old-bridge/2026_higaeri/codes/TFT画面イメージ/image1.jpg

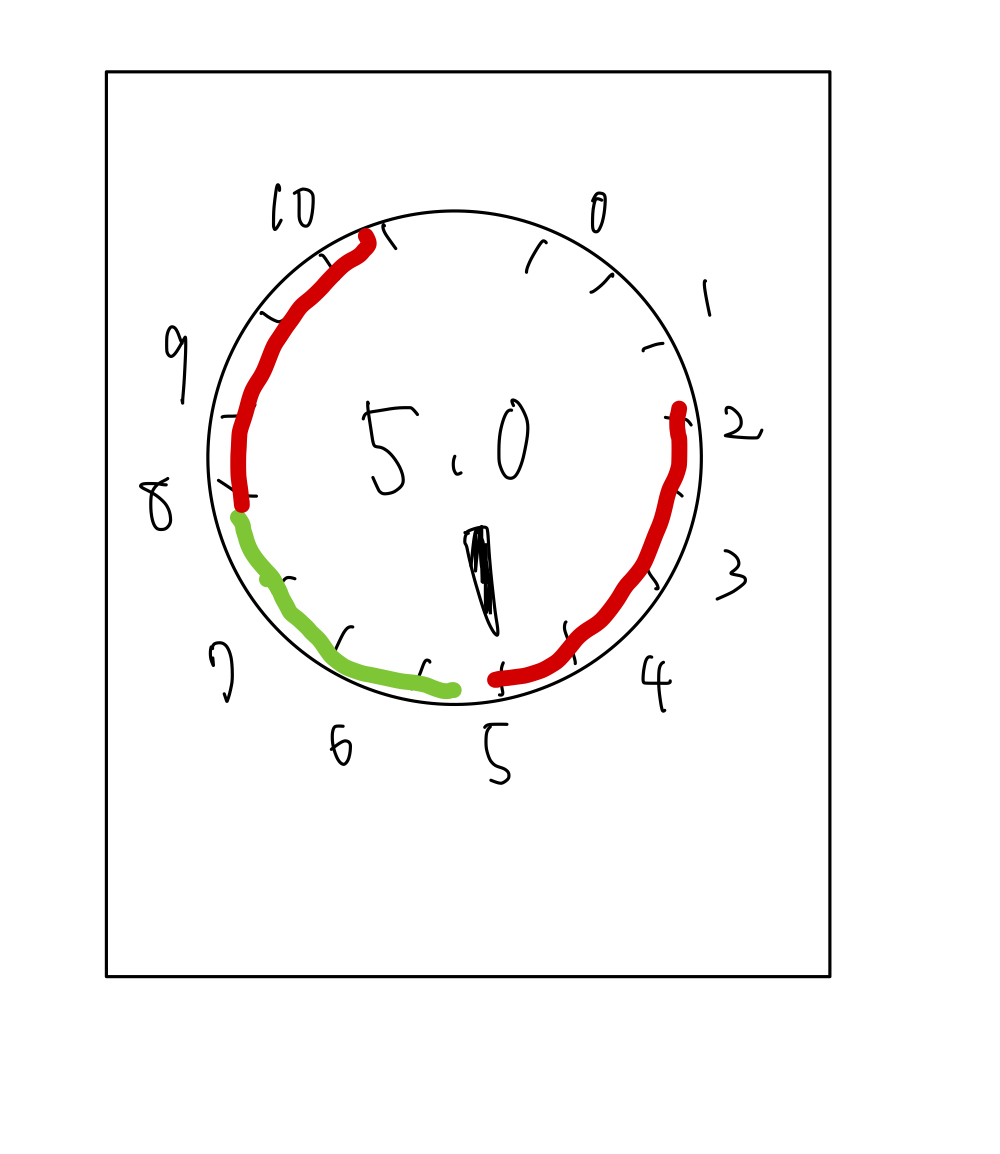
codes/TFT画面イメージ/image1.jpg
