old-bridge/2026_higaeri/codes/COMPILATION_FIXES.md

# Compilation Errors - Fix Summary

## issues Fixed

### 1. **#error "DE_PIN must be defined"**
**Problem**: DE_PIN was defined in the .ino files, but wasn't accessible to the .cpp files when compiled as separate units.

**Solution**: Created `pins.h` files in each subfolder that:
- Define DE_PIN with appropriate values for each board
- Use `#if !defined(DE_PIN)` to allow .ino files to override
- Are included before ModbusConfig.h in all files

**Files created**:
- `air_data/pins.h` (DE_PIN: D10)
- `display/pins.h` (DE_PIN: D3)
- `logger/pins.h` (DE_PIN: D2)
- `master/pins.h` (DE_PIN: D5)
- `slave/pins.h` (DE_PIN: D5)

### 2. **Redefinition Errors in ModbusRTU.h**
**Problem**: ModbusRTU.h was included multiple times without include guards, causing:
- `error: redefinition of 'const uint16_t crc_table [256]'`
- `error: redefinition of 'class ModbusRTU'`
- etc.

**Solution**: 
- Added `#ifndef MODBUS_RTU_H` / `#define MODBUS_RTU_H` guards at the top of `libraries/ModbusRTU/src/ModbusRTU.h`
- Added closing `#endif` at the end
- Direct include of `ModbusRTU.h` is now used because the current library header already has `#pragma once`

**Files modified**:
- `libraries/ModbusRTU/src/ModbusRTU.h` - Added header guards
- Removed local `ModbusRTU_wrapper.h`; local modules include `ModbusRTU.h` directly

### 3. **Include Structure Issues**
**Problem**: 
- .ino files were directly `#include`ing .cpp files, causing duplicate includes
- This resulted in ModbusRTU.h being included multiple times
- Multiple definitions of static variables

**Solution**:
- Removed `#include "ModbusSlave.cpp"` and `#include "ModbusMaster.cpp"` from .ino files
- Let Arduino IDE compile .cpp files as separate compilation units
- Updated .ino files to only include .h files

**Files modified**:
- `air_data/air_data.ino`
- `display/display_d1.ino`

### 4. **Updated ModbusConfig.h**
**Changes**:
- Added `#include "pins.h"` at the top
- Removed the `#error` directive that required manual DE_PIN definition
- Files updated in: air_data/, display/

### 5. **Updated Header Files**
**Changes**:
- ModbusSlave.h and ModbusMaster.h now include `<ModbusRTU.h>` directly
- Files updated in: air_data/, display/

## Remaining Issues

The following API mismatch errors still need investigation:
- `'class ModbusRTU' has no member named 'begin'`
- `'class ModbusRTU' has no member named 'slave'`
- `'class ModbusRTU' has no member named 'task'`
- `'class ModbusRTU' has no member named 'Hreg'`
- `'class ModbusRTU' has no member named 'readHreg'`
- `'class ModbusRTU' has no member named 'writeHreg'`
- `'class ModbusRTU' has no member named 'addHreg'`
- `'class ModbusRTU' has no member named 'onGetHreg'`
- `'class ModbusRTU' has no member named 'onSetHreg'`

These suggest that the ModbusSlave.cpp and ModbusMaster.cpp implementations were written for a different API than what's currently in the ModbusRTU library. The library might have methods like `startModbusServer()` and `startModbusClient()` instead, or the API signatures are different.

## Next Steps

1. Review the ModbusRTU library documentation to understand the correct API
2. Update ModbusSlave.cpp and ModbusMaster.cpp to use the actual available methods
3. Or, if the library version is different from expected, consider updating the library or the implementation files
