old-bridge/2026_higaeri/(commit log)

2026-02-24 Add D-1/D-2 display, ModbusMaster and docs
    Introduce split display firmware and master implementation: add display_d1 (Modbus slave + I2C master to D-2) and display_d2 (I2C slave sensor provider), remove legacy display.ino, and implement ModbusMaster.cpp with synchronous read/write and baud-switch logic. Update ModbusConfig.h to rename/display D-1/D-2 register and slave ID constants, and adjust logger.ino to read from Display D-1 and use the new baud-change flow. Also add .github/copilot-instructions.md documenting system architecture, Modbus register model, and development notes.
2026-03-18 added boards
    [TFTboard.kicad_sch, higaeri.kicad_pcb, higaeri.kicad_sch, loggerboard.kicad_sch, untitled.kicad_sch]
2026-03-20 modbus動作確認できた
2026-03-21 ロガー-ディスプレイ間通信確認
2026-03-23 増幅回路追加
    [RE12A_amplifier.kicad_sch, higaeri.kicad_pcb, higaeri.kicad_sch, loggerboard.kicad_sch, untitled.kicad_sch]
2026-03-23 DRCエラー解消
    [RE12A_amplifier.kicad_sch, TFTboard.kicad_sch, higaeri.kicad_pcb, untitled.kicad_sch]
2026-03-24 シルクスクリーン修正
    [higaeri.kicad_pcb]
2026-03-25 ファイル名変更
    [bom.csv, designators.csv, higaeri.kicad_pcb, positions.csv]
2026-03-25 ライブラリ追加
2026-03-28 動作確認をもとに統合版コード修正
    [RE12A_amplifier.kicad_sch, bom.csv, designators.csv, higaeri.kicad_pcb, positions.csv, untitled.kicad_sch]
2026-03-29 統合版最小構成で動作確認
2026-03-29 air_data: 風速サンプリングをmicros()と実経過時間ベースに変更
    millis()による固定500msウィンドウをmicros()に切り替え、実際の経過時間を計測して
    パルス数/秒を計算するよう修正。ループポーリング遅延によるウィンドウ誤差を除去し、
    計算精度を向上させた。kAirspeedSlopeは再キャリブレーションが必要。
    - `updateWindSpeed()`: micros()で経過時間を計測し`elapsedSec`を算出
    - `convertPulseCountToWindSpeed()`: パルス数/秒ベースの計算に変更
    - `setup()`: 初期化タイマーをmicros()に統一
2026-03-30 display: DPS310読み取りをd2からd1に移管しI2C競合を解消
    display_d2がWireをI2CスレーブとDPS310マスターの両方に使用していたため、
    ESP32C3の単一I2Cコントローラ上で競合が発生し、DPS310が動作せず
    baroAltが常に0になっていた。
    DPS310の読み取りをI2Cマスターであるdisplay_d1に移管することで競合を解消。
    display_d1はWireマスターとしてdisplay_d2(0x30)とDPS310(0x76)の
    両方に直接アクセスする。display_d2はI2Cスレーブ専念となる。
    - display_d2: Adafruit_DPS310削除、baroAltをpayloadから除外
    - display_d2: DisplayD2Config.hから不要な定数(kDps310Address, kSeaLevelPre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
2026-04-01 logger: Modbusブロッキング通信をノンブロッキング化し、通信・ログ周期を独立化
    【元の不具合と問題点】
    logger.ino の pollDevices() は Modbus 通信を同期（ブロッキング）で行っていた。
    具体的には:
    1. air_data からのレジスタ読み込み（最大1秒待機）
    2. display_d1 への airspeed 書き込み（最大1秒待機）
    3. display_d1 からのレジスタ読み込み（最大1秒待機）
    の3操作を順番に、かつ応答が来るまでその場で待つ（ブロッキング）実装だった。
    問題:
    - 最悪3秒間、loop() が止まる
    - Modbus に障害が発生した場合、SD への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
2026-04-01 TFT表示更新
2026-04-04 BNO085、ブザー追加
2026-04-14 対気速度のみテストコード追加
    [airdata_20260411_163107.csv, airdata_20260411_163515.csv, airdata_20260411_163948.csv, airdata_20260411_170748.csv, airdata_20260411_171647.csv]
2026-04-20 1st TFにてESP-NOWで動作
2026-04-24 2nd TF前動作確認
    AoS不動作
    Modbus不調
    風速計係数変更なし
2026-04-30 soft I2CでAoSセンサー動作確認
